sqdlab/SQDelectrik/README.md

# SQDelectrik

This repository details custom electronic circuits for general lab use. This repository holds the schematics and usage documentation:

- [Safe Ohmmeter](Projects/SafeOhmmeter/README.md)
- [Safe Ohmmeter v2](Projects/SafeOhmmeter2/README.md)
