sqdlab/SQDelectrik/Projects/SafeOhmmeter2/Docs/Schematic.pdf

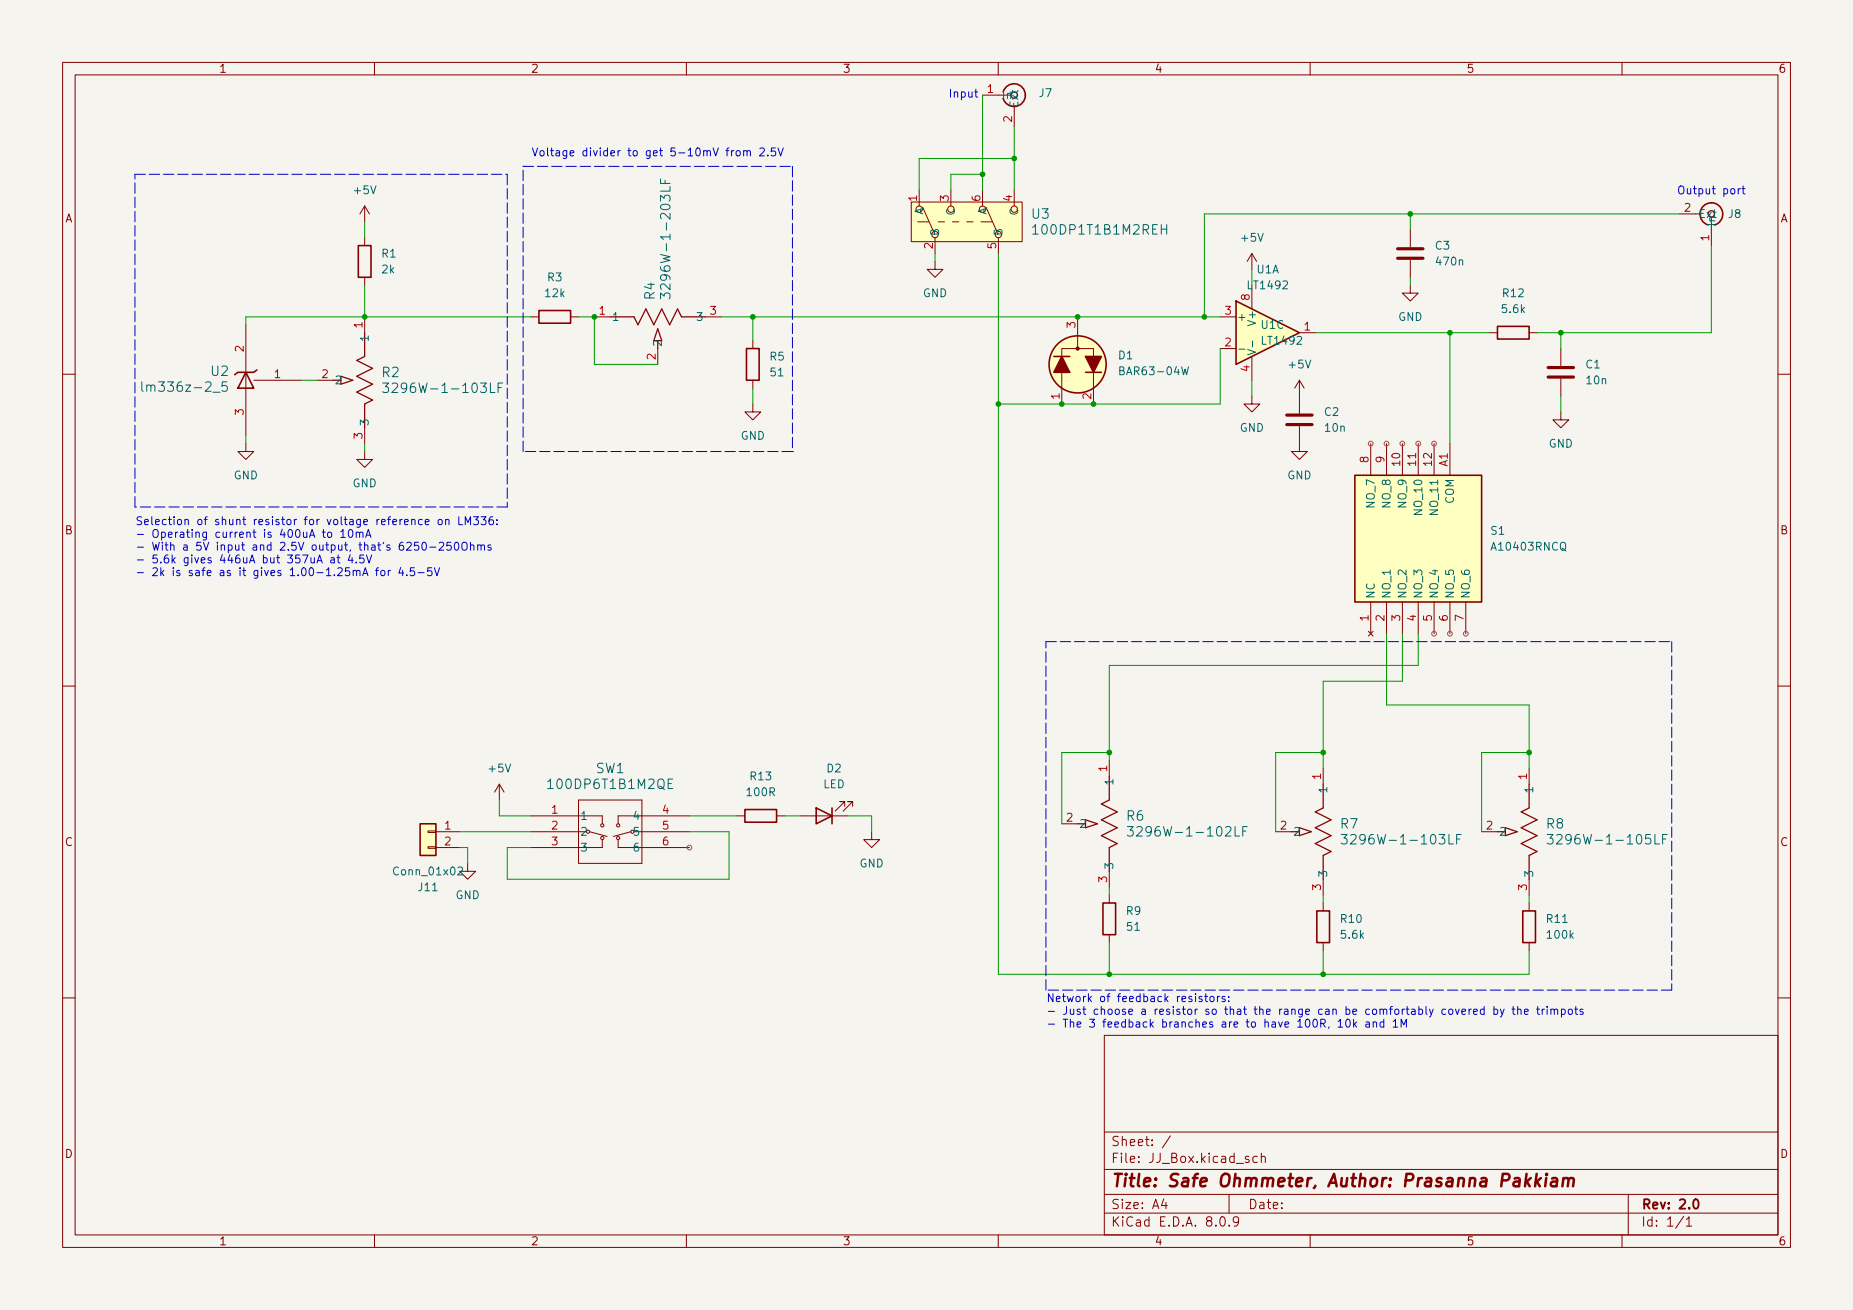
[picture p2: page 1]
