sqdlab/SQDelectrik/Projects/SafeOhmmeter/Docs/Schematic.pdf

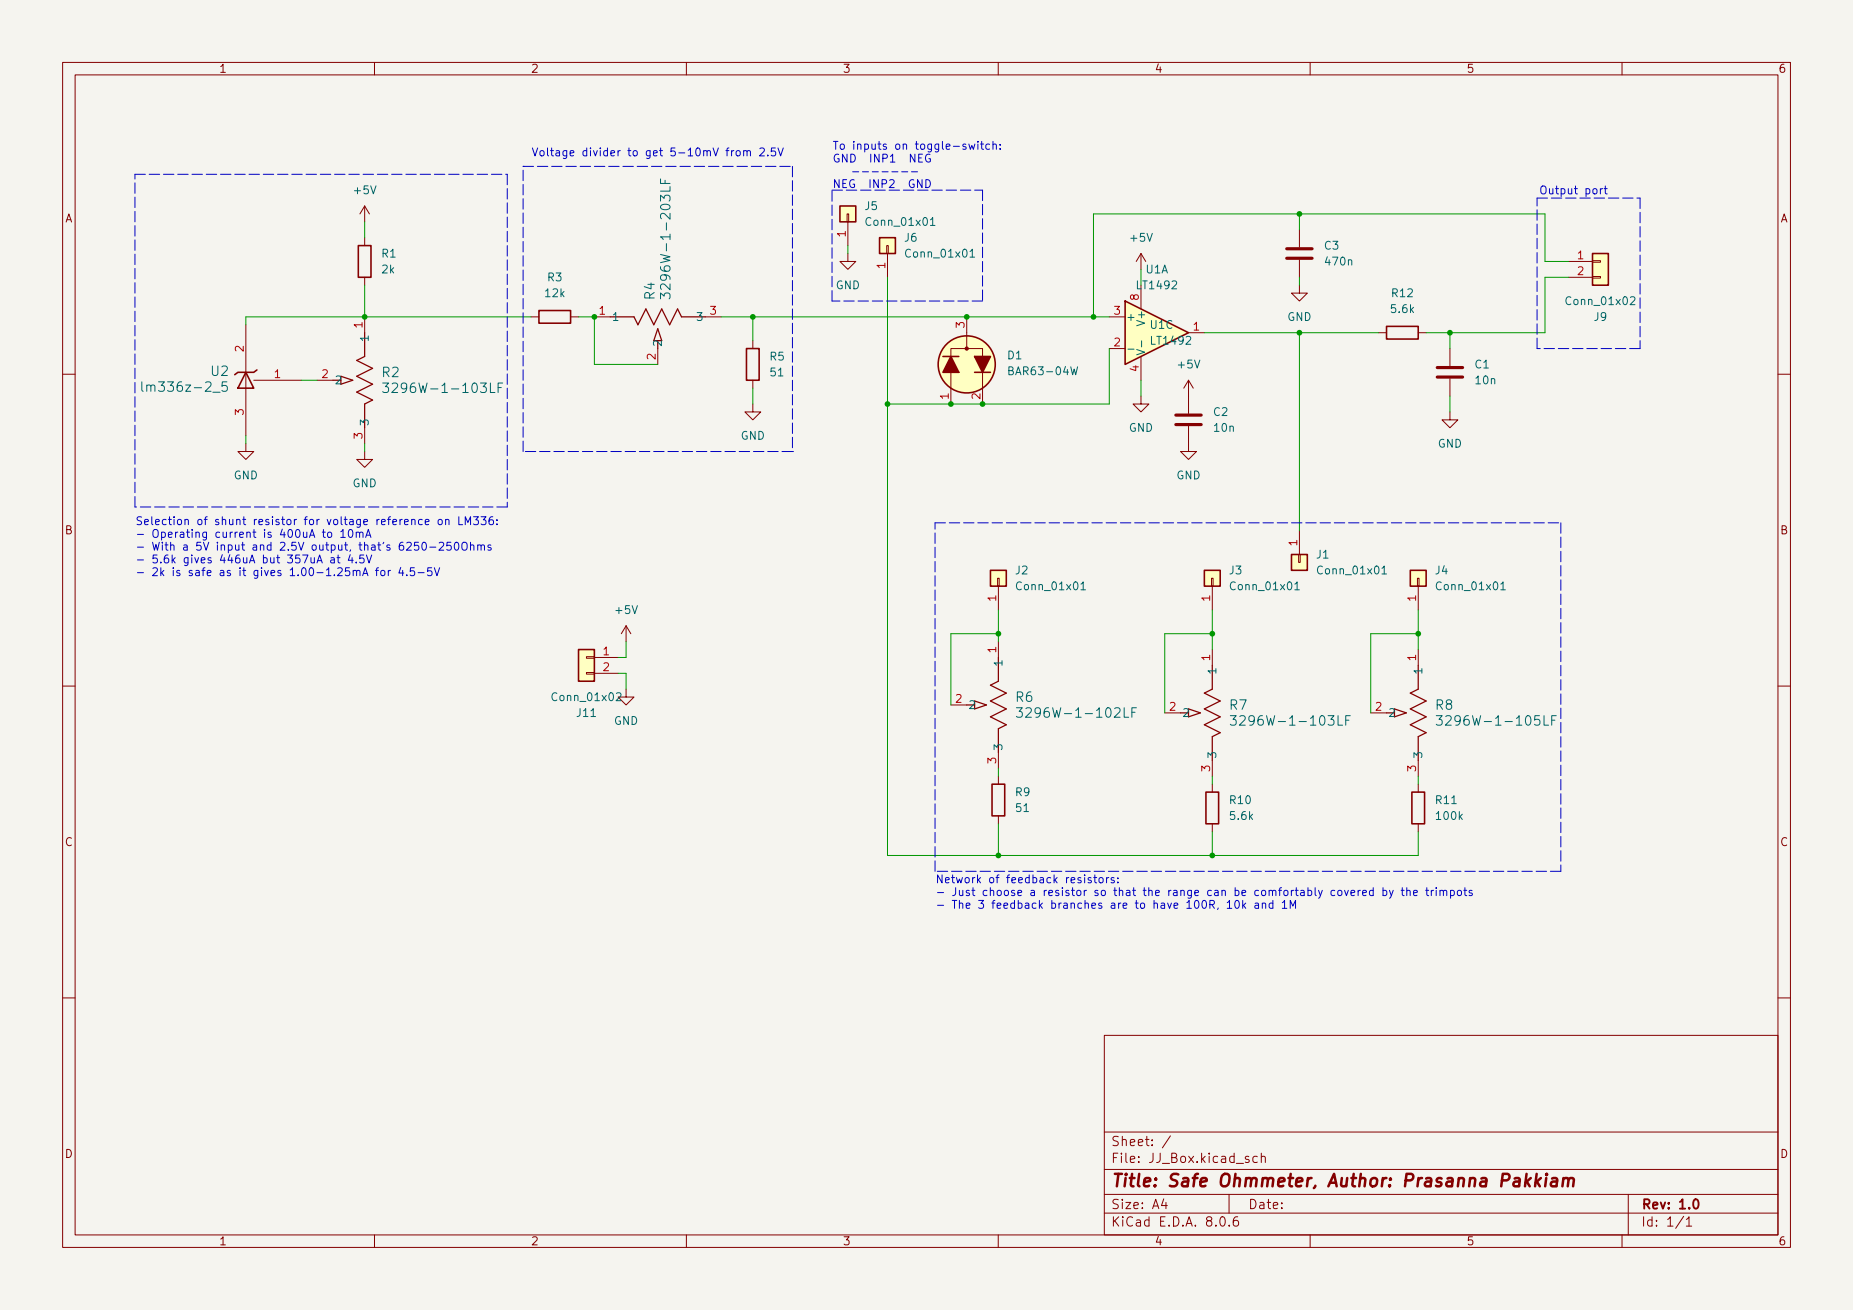
[picture p3: page 1]
