sqdlab/SQDelectrik/(commit log)

2024-10-18 Added safe-Ohmmeter.
    [JJ_Box.kicad_pcb, JJ_Box.kicad_sch]
2026-11-10 Working prototype for new generation SafeOhmmeter
