sqdlab/SQDelectrik/Projects/SafeOhmmeter2/JJ_Box.kicad_pcb

## KiCad design Projects/SafeOhmmeter2/JJ_Box.kicad_pcb (2026-11-10)

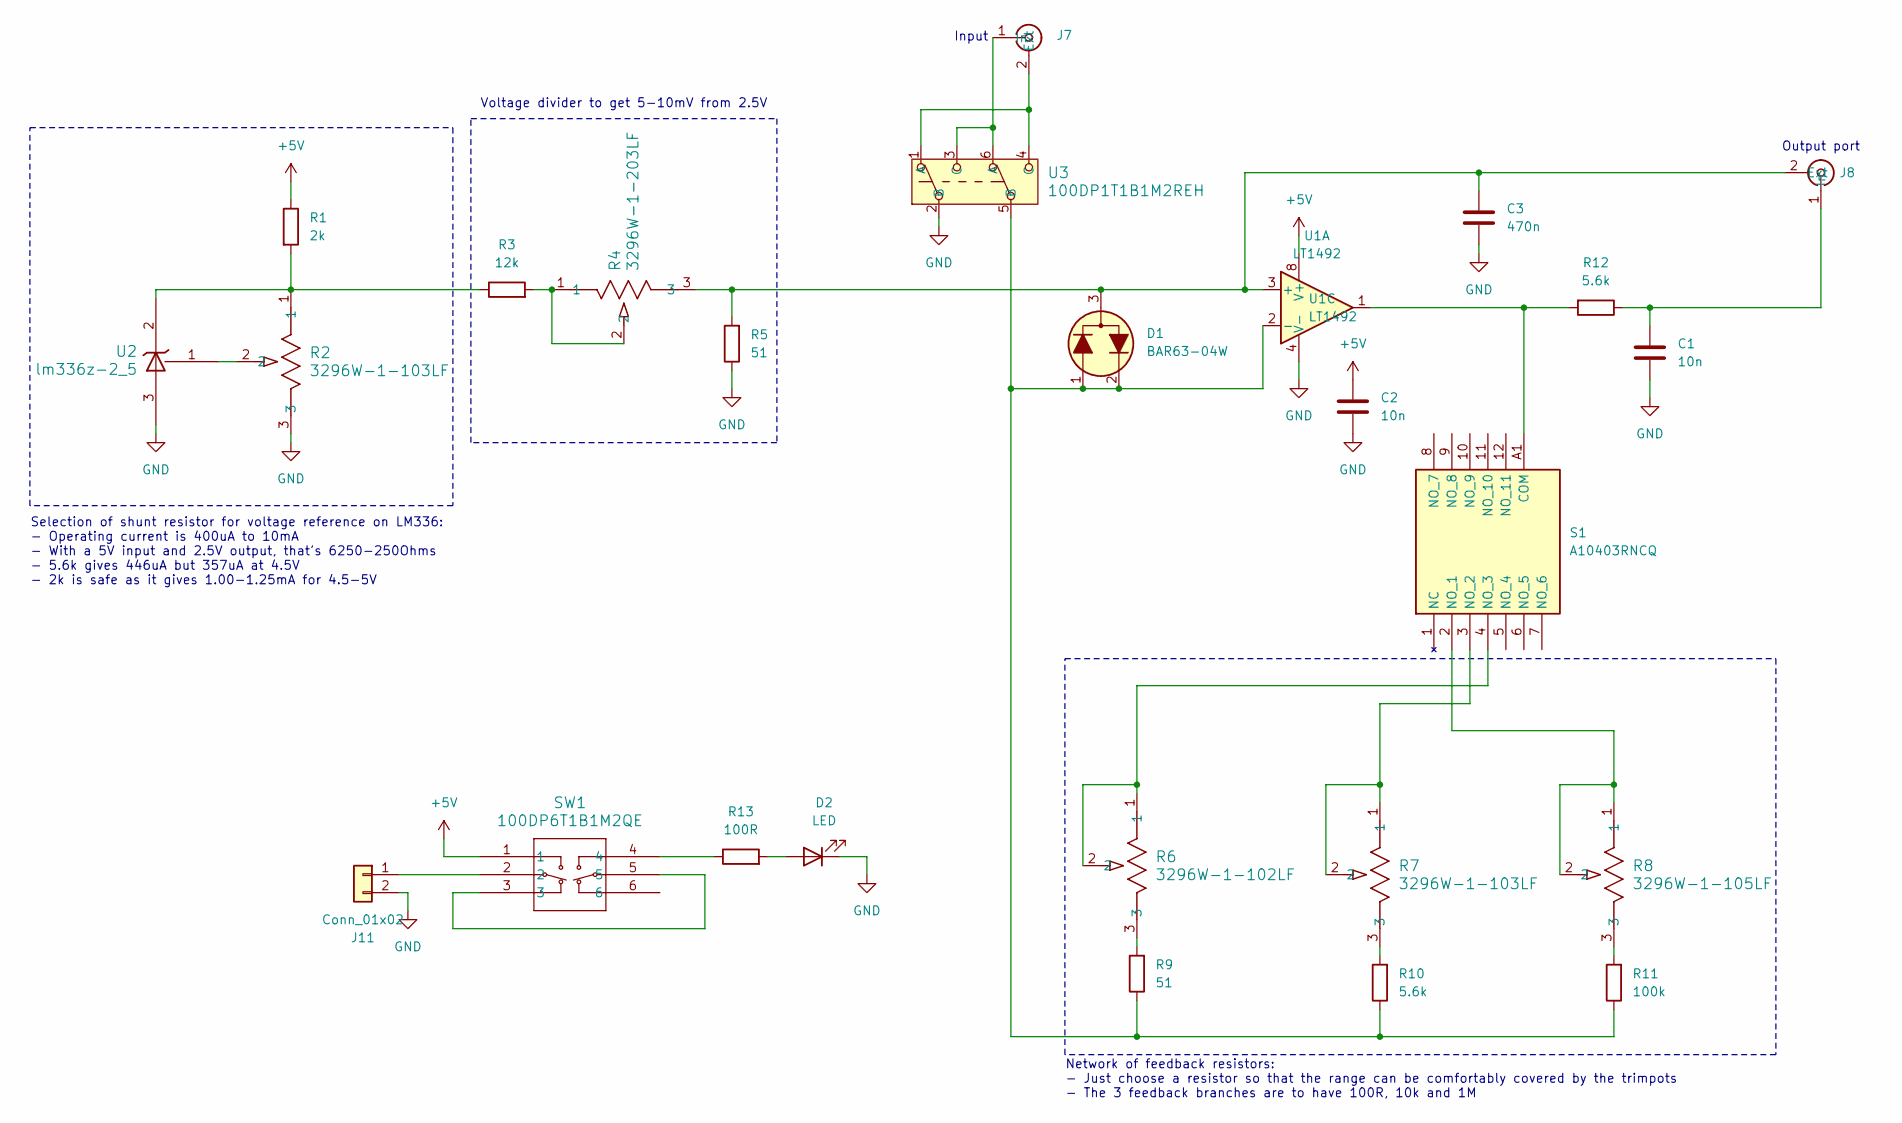
[picture p1: schematic JJ_Box.kicad_sch, Safe Ohmmeter, Author: Prasanna Pakkiam]

Parts:
C1, C2: 10n; C_0603_1608Metric_Pad1.08x0.95mm_HandSolder
C3: 470n; C_0603_1608Metric_Pad1.08x0.95mm_HandSolder
D1: BAR63-04W; SOT-323_SC-70_Handsoldering
D2: LED; LED_D5.0mm
J7, J8: CONN_5227222-3_TYC
J11: Conn_01x02; PinHeader_1x02_P2.54mm_Vertical
R1: 2k; R_0603_1608Metric_Pad0.98x0.95mm_HandSolder
R2, R7: 3296W-1-103LF; POT_3296W
R3: 12k; R_0603_1608Metric_Pad0.98x0.95mm_HandSolder
R4: 3296W-1-203LF; POT_3296W
R5, R9: 51; R_0603_1608Metric_Pad0.98x0.95mm_HandSolder
R6: 3296W-1-102LF; POT_3296W
R8: 3296W-1-105LF; POT_3296W
R10, R12: 5.6k; R_0603_1608Metric_Pad0.98x0.95mm_HandSolder
R11: 100k; R_0603_1608Metric_Pad0.98x0.95mm_HandSolder
R13: 100R; R_0603_1608Metric_Pad0.98x0.95mm_HandSolder
S1: A10403RNCQ; A10405RNCQE; Manufacturer_Part_Number A10403RNCQ
SW1: 100DP6T1B1M2QE; 100DP8T6B11M2QEH_EWI
U1: LT1492; SOIC-8_3.9x4.9mm_P1.27mm
U2: lm336z-2_5; Z03A_TEX
U3: 100DP1T1B1M2REH; SW6_100DP1T1B1M2REH

Connections:
+5V: C2.1, R1.1, SW1.1, U1.8 (V+)
GND: C1.2, C2.2, C3.2, D2.1 (K), J11.2, R2.3, R5.1, U1.4 (V-), U2.3 (-V), U3.2 (B)
unnamed: D1.1 (A), D1.2 (K), R9.1, R10.1, R11.1, U1.2 (-), U3.5 (B)
unnamed: C3.1, D1.3 (C), J8.2 (Ext), R4.3, R5.2, U1.3 (+)
unnamed: D2.2 (A), R13.2
unnamed: J7.2 (Ext), U3.1 (A), U3.4 (C)
unnamed: J7.1 (In), U3.3 (C), U3.6 (A)
unnamed: C1.1, J8.1 (In), R12.1
unnamed: J11.1, SW1.2
unnamed: R3.2, R4.1, R4.2
unnamed: R6.3, R9.2
unnamed: R7.3, R10.2
unnamed: R8.3, R11.2
unnamed: R13.1, SW1.4
unnamed: R12.2, S1.A1 (COM), U1.1
unnamed: R8.1, R8.2, S1.2 (NO_1)
unnamed: R7.1, R7.2, S1.3 (NO_2)
unnamed: R6.1, R6.2, S1.4 (NO_3)
unnamed: SW1.3, SW1.5
unnamed: R1.2, R2.1, R3.1, U2.2 (+V)
unnamed: R2.2, U2.1 (ADJ)

Notes on the sheet:
Voltage divider to get 5-10mV from 2.5V
Output port
Input
Network of feedback resistors: - Just choose a resistor so that the range can be comfortably covered by the trimpots - The 3 feedback branches are to have 100R, 10k and 1M
Selection of shunt resistor for voltage reference on LM336: - Operating current is 400uA to 10mA - With a 5V input and 2.5V output, that's 6250-250Ohms - 5.6k gives 446uA but 357uA at 4.5V - 2k is safe as it gives 1.00-1.25mA for 4.5-5V

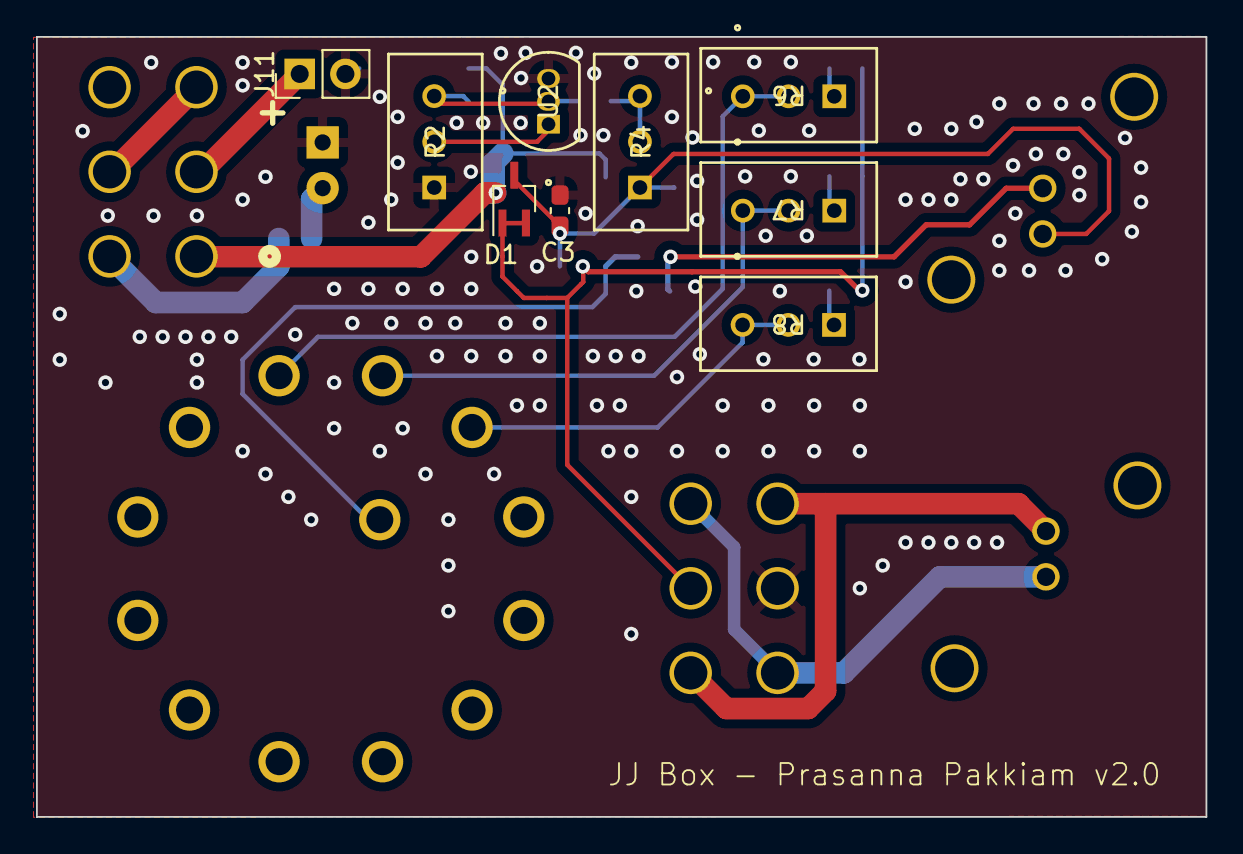
[picture p2: board Projects/SafeOhmmeter2/JJ_Box.kicad_pcb from above]

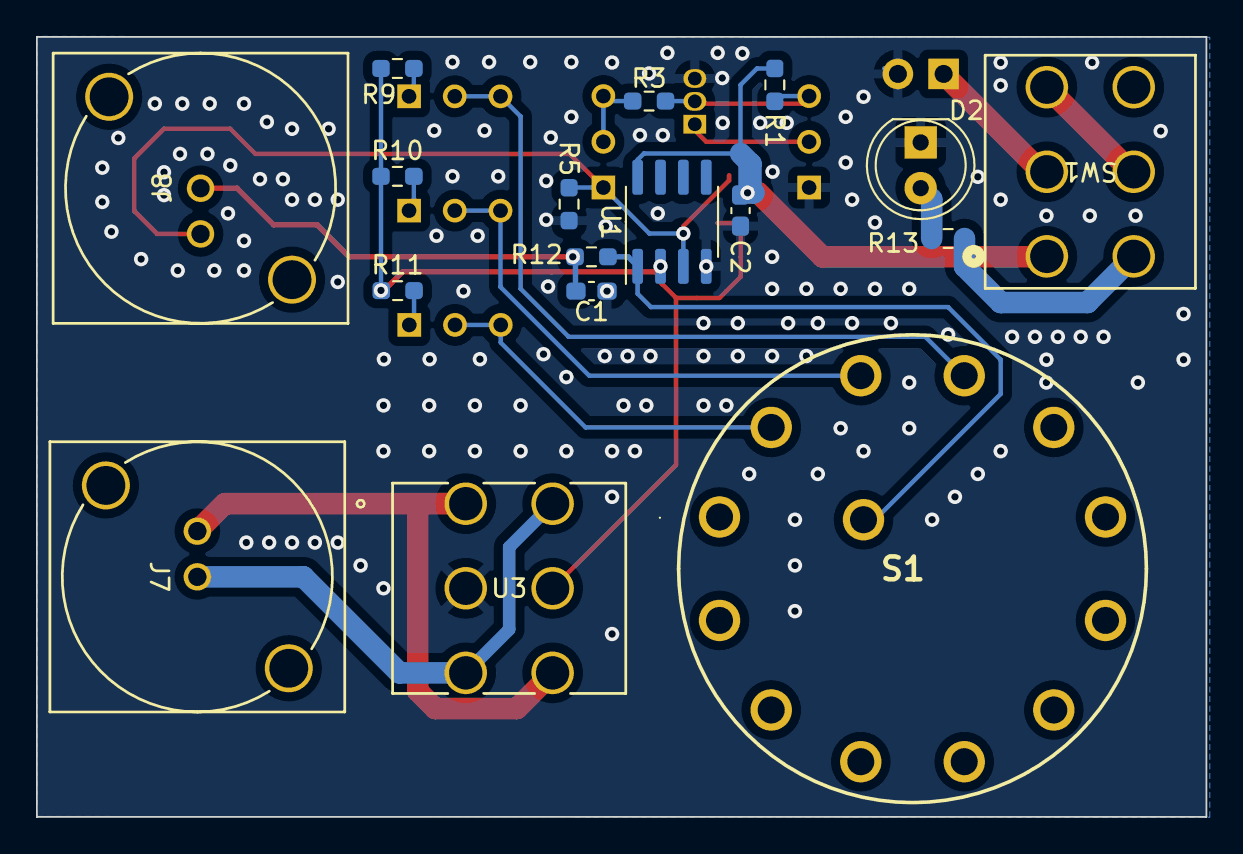
[picture p3: board Projects/SafeOhmmeter2/JJ_Box.kicad_pcb from below]

Board: 2 copper layers, 65.0 x 43.3 mm, 26 parts (17 on the bottom side), 21 nets.
