sqdlab/SQDelectrik/Projects/SafeOhmmeter/JJ_Box.kicad_pcb

## KiCad design Projects/SafeOhmmeter/JJ_Box.kicad_pcb (2024-10-18, an earlier design)

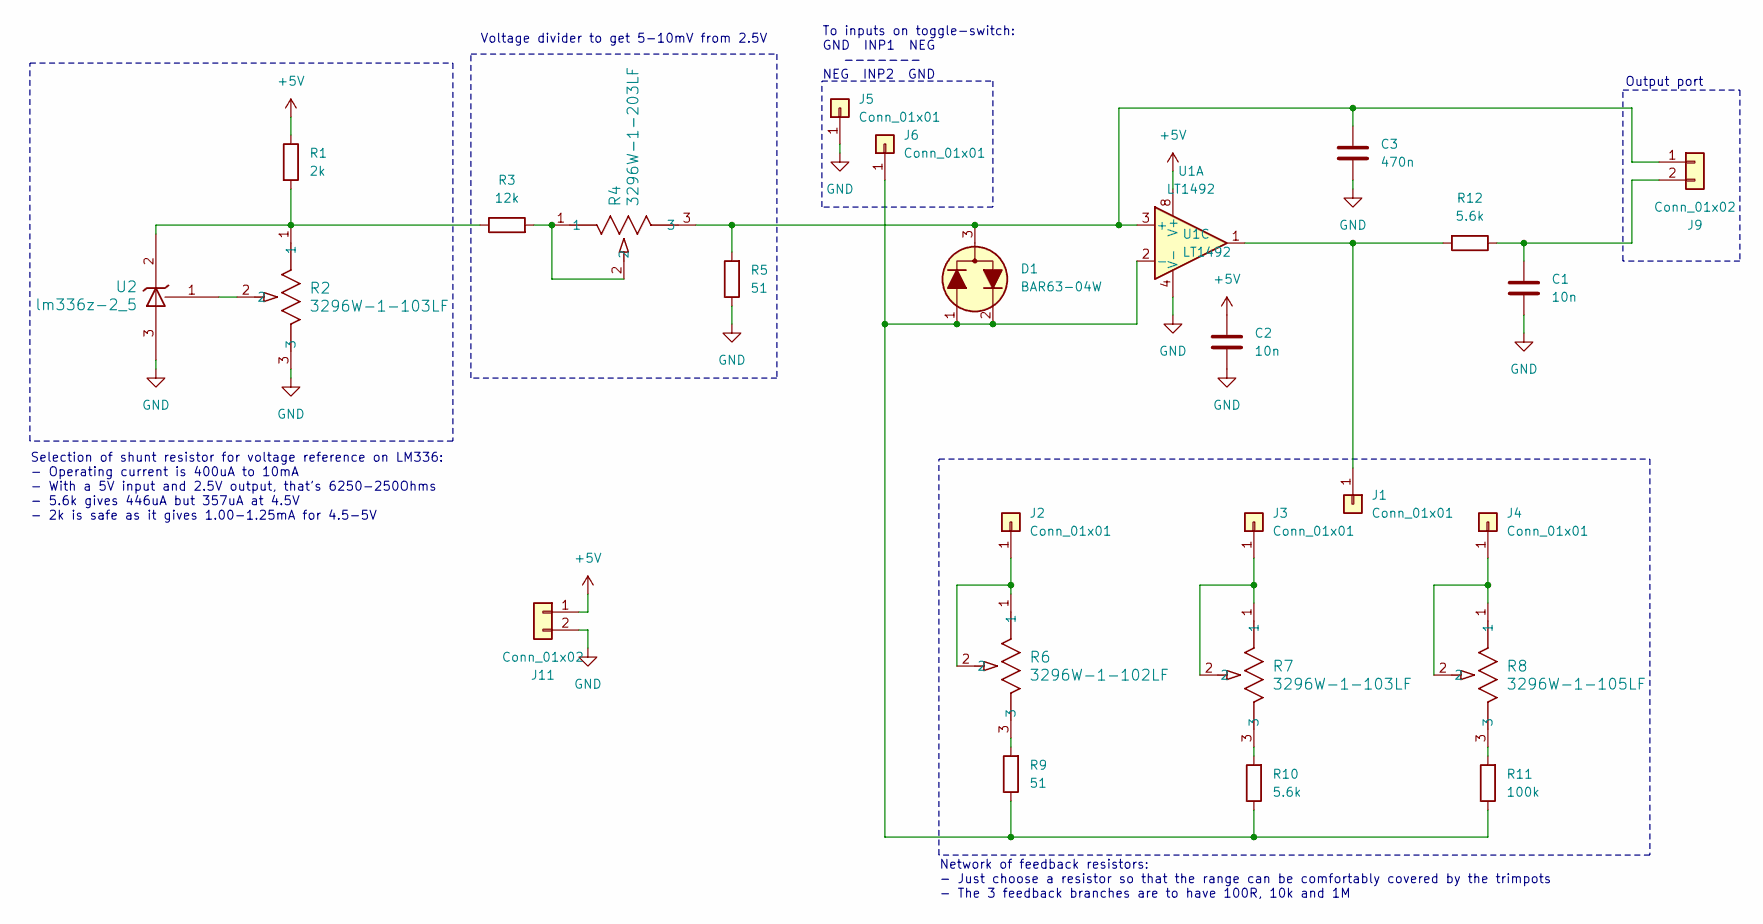
[picture p4: schematic JJ_Box.kicad_sch, Safe Ohmmeter, Author: Prasanna Pakkiam]

Parts:
C1, C2: 10n; C_0603_1608Metric_Pad1.08x0.95mm_HandSolder
C3: 470n; C_0603_1608Metric_Pad1.08x0.95mm_HandSolder
D1: BAR63-04W; SOT-323_SC-70_Handsoldering
J1, J2, J3, J4, J5, J6: Conn_01x01; PinHeader_1x01_P2.54mm_Vertical
J9, J11: Conn_01x02; PinHeader_1x02_P2.54mm_Vertical
R1: 2k; R_0603_1608Metric_Pad0.98x0.95mm_HandSolder
R2, R7: 3296W-1-103LF; POT_3296W
R3: 12k; R_0603_1608Metric_Pad0.98x0.95mm_HandSolder
R4: 3296W-1-203LF; POT_3296W
R5, R9: 51; R_0603_1608Metric_Pad0.98x0.95mm_HandSolder
R6: 3296W-1-102LF; POT_3296W
R8: 3296W-1-105LF; POT_3296W
R10, R12: 5.6k; R_0603_1608Metric_Pad0.98x0.95mm_HandSolder
R11: 100k; R_0603_1608Metric_Pad0.98x0.95mm_HandSolder
U1: LT1492; SOIC-8_3.9x4.9mm_P1.27mm
U2: lm336z-2_5; Z03A_TEX

Connections:
+5V: C2.1, J11.1, R1.1, U1.8 (V+)
GND: C1.2, C2.2, C3.2, J5.1, J11.2, R2.3, R5.1, U1.4 (V-), U2.3 (-V)
unnamed: D1.1 (A), D1.2 (K), J6.1, R9.1, R10.1, R11.1, U1.2 (-)
unnamed: C3.1, D1.3 (C), J9.1, R4.3, R5.2, U1.3 (+)
unnamed: J1.1, R12.2, U1.1
unnamed: J2.1, R6.1, R6.2
unnamed: J3.1, R7.1, R7.2
unnamed: J4.1, R8.1, R8.2
unnamed: C1.1, J9.2, R12.1
unnamed: R3.2, R4.1, R4.2
unnamed: R6.3, R9.2
unnamed: R7.3, R10.2
unnamed: R8.3, R11.2
unnamed: R1.2, R2.1, R3.1, U2.2 (+V)
unnamed: R2.2, U2.1 (ADJ)

Notes on the sheet:
Voltage divider to get 5-10mV from 2.5V
Output port
Network of feedback resistors: - Just choose a resistor so that the range can be comfortably covered by the trimpots - The 3 feedback branches are to have 100R, 10k and 1M
Selection of shunt resistor for voltage reference on LM336: - Operating current is 400uA to 10mA - With a 5V input and 2.5V output, that's 6250-250Ohms - 5.6k gives 446uA but 357uA at 4.5V - 2k is safe as it gives 1.00-1.25mA for 4.5-5V
To inputs on toggle-switch: GND INP1 NEG ------- NEG INP2 GND

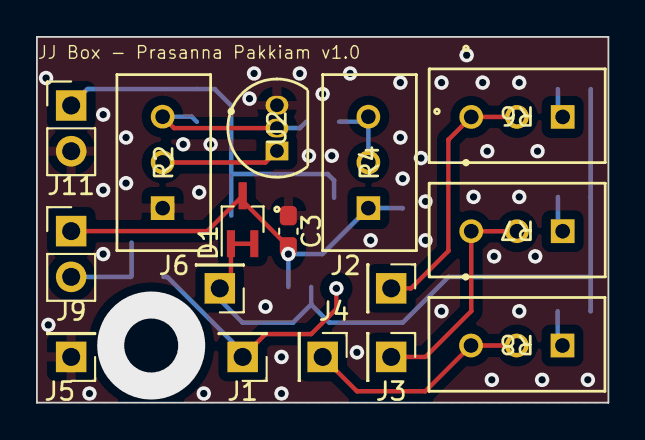
[picture p5: board Projects/SafeOhmmeter/JJ_Box.kicad_pcb from above]

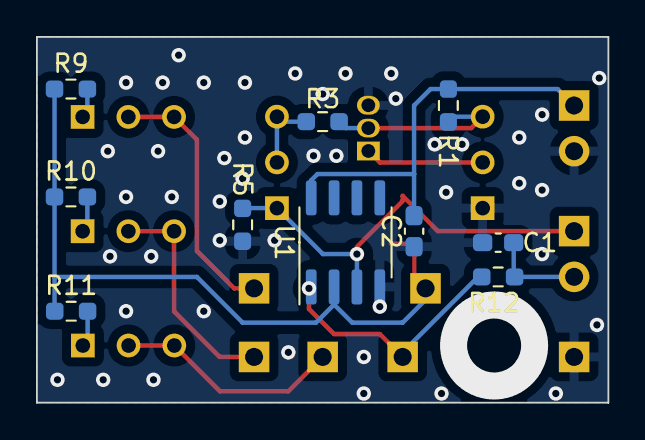
[picture p6: board Projects/SafeOhmmeter/JJ_Box.kicad_pcb from below]

Board: 2 copper layers, 31.8 x 20.3 mm, 26 parts (10 on the bottom side), 15 nets.
